Jaimee007/Modular_Drawers/docs/04_diseno_software.md

# Diseño de software

Versión 2.0 · Octubre 2026 · **Firmware del módulo, del controlador e integración en Home Assistant**

> **Alcance.** Qué software corre en cada sitio, cómo se organiza y en qué orden se construye y prueba. Implementa `01_especificacion_funcional.md` sobre el hardware de `02_diseno_hardware.md`.
>
> Entorno: **VS Code + PlatformIO**.

---

## 1. Las tres piezas de software

| Pieza | Dónde corre | Lenguaje / framework |
|---|---|---|
| **Firmware del módulo** | CH32V003 (uno por unidad de retícula) | C sobre `ch32v003fun` |
| **Firmware del controlador** | ESP32-C3 (módulo base) | C++ como componente externo de ESPHome |
| **Integración** | Home Assistant | YAML, plantillas y scripts |

### 1.1 Reparto de responsabilidades

El principio que lo gobierna todo viene del requisito **R1**:

> **Un cajón que se abre se ilumina aunque el controlador no responda.**

De ahí sale la línea divisoria:

| Lo decide **el módulo**, solo | Lo decide **el controlador** |
|---|---|
| Encender en blanco al abrir | Qué cajones están siendo buscados |
| El verde de "encontrado" y cancelar la búsqueda | El mapa de posiciones |
| Parpadear en ámbar si no tiene dirección | Detectar direcciones duplicadas y errores de montaje |
| Filtrar los rebotes del interruptor | Agrupar módulos emparejados en un cajón |
| Reiniciarse si se cuelga | Límites de brillo y de LED simultáneos |

**El módulo tiene prioridad.** Si el controlador pide azul y el cajón se abre, gana el blanco.

---

## 2. Estructura del repositorio

```
Modular_Drawers/
├── firmware/
│   ├── modulo/                  ← proyecto PlatformIO del CH32V003
│   │   ├── platformio.ini
│   │   ├── include/
│   │   │   ├── bus.h            ← protocolo y CRC, COMPARTIDO
│   │   │   └── funconfig.h
│   │   └── src/main.c
│   └── base_test/               ← proyecto del ESP32 (pruebas, fases 3-6)
│       ├── platformio.ini
│       └── src/main.cpp
├── esphome/
│   ├── components/cajonera/     ← componente externo (fase 7)
│   └── cajonera.yaml
└── homeassistant/
    ├── scripts.yaml
    └── dashboard.yaml
```

> **`bus.h` tiene que ser un único archivo compartido** por los dos proyectos. El formato de trama y el CRC duplicados en dos sitios es una fuente garantizada de fallos difíciles de diagnosticar.

### 2.1 Configuración de PlatformIO

**`firmware/modulo/platformio.ini`**

```ini
[env:modulo]
platform = https://github.com/Community-PIO-CH32V/platform-ch32v.git
board = genericCH32V003F4P6
framework = ch32v003fun
upload_protocol = minichlink
```

**`firmware/base_test/platformio.ini`**

```ini
[env:base]
platform = espressif32
board = esp32-c3-devkitm-1
framework = arduino
monitor_speed = 115200
build_flags =
  -DARDUINO_USB_MODE=1
  -DARDUINO_USB_CDC_ON_BOOT=1
```

Las dos `build_flags` hacen que el `Serial` del ESP32-C3 SuperMini salga por su USB-C.

**Por qué `ch32v003fun` y no Arduino:** ocupa muy poco (el micro tiene 16 kB de flash y 2 kB de RAM), da acceso directo al UART en modo half-duplex —que es lo que necesita el bus— y permite manejar los tres canales del LED por PWM.

---

## 3. Firmware del módulo

### 3.1 Al arrancar

1. Leer los **5 puentes de dirección** (una sola vez). Si la dirección es 0 → estado "sin configurar".
2. Leer los **2 puentes de emparejamiento** (JP7 izquierda, JP8 abajo).
3. Configurar los 4 SENSE como entradas con pull-up.
4. **Anunciarse:** poner los 4 SENSE a 0 durante 50 ms, para que los vecinos detecten el módulo nuevo.
5. Configurar la USART1 en half-duplex y los tres canales PWM del LED (PC6 = rojo, PC7 = verde, PD0 = azul).
6. Activar el watchdog.

### 3.2 Bus: lo que hay que acertar

| Asunto | Cómo |
|---|---|
| **Modo half-duplex** | Bit HDSEL de la USART1; el pin de DATA como salida de función alternativa **open-drain** |
| **El eco** | En half-duplex el receptor oye lo que transmite el propio micro. Hay que **descartar ese eco** o desactivar la recepción mientras se transmite |
| **Recepción** | Por interrupción, con búfer y máquina de estados que reconoce la trama |
| **Responder** | Solo si `DIR` coincide. Esperar ~100 µs antes de contestar, para que el controlador libere la línea |
| **Trama** | `[0xA5] [DIR] [CMD] [LEN] [DATOS...] [CRC8]` |

### 3.3 Máquina de estados del LED

Implementa la tabla de la especificación §4.1, con esta prioridad:

```
1. Sin dirección (ámbar parpadeante)      ← máxima
2. Cajón abierto (blanco, o verde 2 s si estaba buscado)
3. Lo que pida el controlador (búsqueda, error, identificar)
4. Reposo (apagado)                        ← mínima
```

**Detalle del LED RGB:** son **tres canales PWM** (R, G, B), uno por pin, a través de un MOSFET: pin a 1 = color encendido. No hay canal blanco: el "blanco" es R + G + B a la vez. Hay que comprobar que PC6, PC7 y PD0 admiten PWM por hardware (temporizadores TIM1/TIM2, con remapeo); si no, se hace por software. Los MOSFET dejan los colores apagados mientras el micro arranca, por la resistencia de 100 kΩ de cada puerta.

### 3.4 Final de carrera

- Entrada con pull-up. **Cerrado = pulsado = 0.**
- **Antirrebote por software, 25 ms:** el estado solo cambia si se mantiene estable ese tiempo.
- Al detectar apertura, **encender el LED en blanco inmediatamente**, sin consultar al bus.

### 3.5 SENSE

| Comando | Comportamiento |
|---|---|
| `SENSE_DRIVE n` | Poner a 0 el SENSE de la cara n |
| `SENSE_RELEASE` | Volver todos a entrada con pull-up |
| `SENSE_QUERY` | Si ve algún SENSE a 0 que él no está tirando, responde con su dirección y el número de cara. Si no ve ninguno, **no responde** |

**Interrupción en los SENSE:** al detectar un flanco de bajada que él no ha provocado, guarda el aviso "vecino nuevo en la cara k" para el siguiente `GET_STATE`.

### 3.6 Robustez

| Medida | Detalle |
|---|---|
| **Watchdog (IWDG)** | Si el firmware se cuelga, el micro se reinicia solo |
| **Tiempo sin órdenes** | Si pasan más de 30 s sin recibir nada del controlador, apaga la búsqueda pero **sigue encendiendo la luz al abrirse** |
| **Límite de brillo** | Por defecto en el firmware |

---

## 4. Firmware del controlador

### 4.1 Sondeo

| | |
|---|---|
| Cada ~100 ms | pregunta a todas las direcciones conocidas |
| Reintentos | 2 por sondeo; tras 3 fallos seguidos, marca el módulo como "desconectado" |
| Cada ~5 s | pregunta a direcciones desconocidas, para descubrir módulos nuevos |

Esto da una latencia de detección de apertura de ~0,1 s, holgadamente dentro del medio segundo que pide la especificación.

### 4.2 Descubrimiento de la topología

Implementa el algoritmo de `02_diseno_hardware.md` §9.2. Con un módulo por unidad de retícula, el cálculo de posición es directo:

| Cara | Posición del vecino |
|---|---|
| arriba | `(x, y+1)` |
| abajo | `(x, y−1)` |
| derecha | `(x+1, y)` |
| izquierda | `(x−1, y)` |

**Validaciones que debe hacer:**

| Comprobación | Si falla |
|---|---|
| Dos módulos en la misma celda | error de montaje |
| Conexión recíproca (si A ve a B por la derecha, B debe ver a A por la izquierda) | error de montaje |
| Un módulo declara pareja donde no tiene vecino | error de montaje |
| Un módulo sin camino hasta la base | "sin posición", pero sigue funcionando |

### 4.3 Agrupación de cajones

A partir de los puentes JP7/JP8:

1. Cada módulo que declara "pareja a la izquierda" se une al de `(x−1, y)`.
2. Cada módulo que declara "pareja abajo" se une al de `(x, y−1)`.
3. El **módulo principal** de un grupo es el que no declara nada. Da nombre a la entidad.
4. Un grupo expone **una sola entidad de cajón** en Home Assistant.
5. Una orden de iluminación al grupo se envía a **todos** sus módulos.

### 4.4 Límites

| Límite | Valor |
|---|---|
| LED encendidos a la vez | 10 |
| Brillo máximo | limitado |
| Duración de una búsqueda | 30 s |

---

### 4.5 Pines de la SuperMini

Misma asignación que `02_diseno_hardware.md` §10. El firmware la usa tal cual:

| GPIO | Función |
|---|---|
| GPIO21 (TX) | Bus DATA, a través del Schottky |
| GPIO20 (RX) | Bus DATA |
| GPIO0 / GPIO1 / GPIO3 / GPIO10 | SENSE L / R / U / D |
| GPIO8 | LED de estado |

## 5. Integración en Home Assistant

### 5.1 Entidades que publica el componente

Por cada **cajón** (no por módulo):

| Entidad | Uso |
|---|---|
| `light.cajon_NN` | RGB con efectos de parpadeo |
| `binary_sensor.cajon_NN_abierto` | Estado del cajón |
| `text.cajon_NN_contenido` | Descripción; **persistida en el ESP32** (requisito R6) |
| `sensor.cajon_NN_x`, `_y`, `_tamano` | Para dibujar la cajonera |

Y a nivel de sistema: un botón **"Redescubrir cajonera"** y entidades de aviso para cajones nuevos, direcciones duplicadas y errores de montaje.

### 5.2 Búsqueda

Script `buscar_componente`:

1. Recibe un texto ("10k").
2. Lo busca en el `text` de contenido de cada cajón.
3. Hace parpadear en azul los que coinciden.
4. Los apaga al abrirse uno, o a los 30 s.

**Assist (voz):** un intent personalizado del tipo *"¿dónde están las {cosa}?"* que llama al script.

**Panel:** una tarjeta con la cuadrícula dibujada a partir de las posiciones X/Y, el color de cada cajón y su contenido. Al tocar un cajón, se identifica parpadeando.

### 5.3 Plan B

Si el componente externo de ESPHome se complica, se mantiene el firmware Arduino de `base_test` y se publican las entidades por **MQTT con descubrimiento automático**. Funciona igual en Home Assistant.

---

## 6. Plan de construcción y pruebas

Cada fase termina con una **prueba de aceptación**. No pasar a la siguiente hasta que la anterior funcione: así, cuando algo falle, el problema está en lo último que se añadió.

| Fase | Objetivo | Hardware | Duración |
|---|---|---|---|
| 0 | Entorno y repositorio | PC, WCH-LinkE | 1–2 h |
| 1 | Primer programa: parpadeo y `printf` | 1 micro | 1 h |
| 2 | Periféricos, uno a uno | + LED, interruptor, puentes | 3–4 h |
| 3 | Bus DATA: el controlador habla con un módulo | + ESP32, diodo Schottky, resistencias | 4–6 h |
| 4 | Dos módulos en el mismo bus | 2.º micro | 1–2 h |
| 5 | SENSE: descubrimiento de posición | Cables entre placas | 3–4 h |
| 6 | Emparejamiento y lógica completa | — | 3–4 h |
| 7 | Integración con Home Assistant | HA funcionando | 4–6 h |
| 8 | Búsqueda, panel y voz | — | 2–3 h |
| 9 | Prueba final con cajones impresos | Armazones v1 | 2 h |

### Fase 0 · Entorno

1. **VS Code** y la extensión **PlatformIO IDE**.
2. La plataforma CH32V: `pio pkg install -g -p https://github.com/Community-PIO-CH32V/platform-ch32v.git`
3. **WCH-LinkUtility**, para dos cosas:
   - **Actualizar el firmware del WCH-LinkE.** Con firmware antiguo, la grabación falla con "Programming Failed".
   - **Ponerlo en modo RISC-V.** El WCH-LinkE tiene modo ARM y modo RISC-V; **en modo ARM no reconoce el CH32V003**. Se cambia desde la utilidad o con el botón "ModeS".

✅ **Aceptación:** los dos proyectos compilan.

### Fase 1 · Primer programa

**Conexión del programador:**

| WCH-LinkE | Módulo |
|---|---|
| 3V3 | 3V3 — **solo si no hay 5 V en el bus** |
| GND | GND |
| SWDIO | SWIO |

> ⚠️ Si el módulo ya recibe corriente del bus, conecta **solo GND y SWIO**. Dos fuentes peleando por el raíl de 3,3 V.

`printf` sale por el mismo hilo SWIO que se usa para programar, lo cual es muy útil porque el UART del micro estará ocupado con el bus. Se activa en `funconfig.h` y se lee con `minichlink -T`.

✅ **Aceptación:** el LED parpadea, se ve el contador en el terminal, y se puede grabar 5 veces seguidas sin errores.

### Fase 2 · Periféricos

| Bloque | Prueba | Aceptación |
|---|---|---|
| **LED RGB** | Ciclo rojo → verde → azul → blanco (R+G+B) → apagado | Colores limpios, sin parpadeos raros, y el blanco reconocible como blanco |
| **Final de carrera** | Imprimir "ABIERTO"/"CERRADO" en cada cambio | 50 aperturas y cierres generan **exactamente 100 eventos**, sin duplicados por rebotes |
| **Puentes** | Imprimir dirección y emparejamiento al arrancar | Las direcciones 1, 2, 21 y 31 se leen bien; con dirección 0 el LED parpadea en ámbar |
| **SENSE** | Imprimir el estado de los 4 pines cada 200 ms | Cada pin cambia a 0 solo al llevarlo a GND, sin afectar a los otros |

### Fase 3 · Bus DATA

**Montaje:**

| Conexión | Detalle |
|---|---|
| GND común | ESP32, micro y programador |
| Pull-up del bus | 4,7 kΩ entre DATA y 3V3, **solo en la base** |
| ESP32 RX | Directo a DATA |
| ESP32 TX | A DATA a través de un diodo Schottky (cátodo hacia el TX) |
| Micro DATA | A través de 1 kΩ |

**Menú de pruebas por el monitor serie:**

```
ping 1            → PING al módulo 1
led 1 0 0 255     → módulo 1 en azul (R G B)
state 1           → estado (abierto/cerrado)
stress 1 1000     → 1000 PING seguidos y recuento de errores
```

**Depuración con el analizador lógico** (canales según los puntos de test de la placa): DATA, LED, y dos SENSE. En PulseView, decodificador UART a 115200 8N1 sobre el canal de DATA.

✅ **Aceptación:** `ping 1` responde siempre, `led` cambia el color al momento, y `stress 1 1000` da **0 errores**.

### Fase 4 · Dos módulos

1. Segundo módulo con **dirección 2**, su DATA a la misma línea con su propia resistencia de 1 kΩ.
2. `ping 1` y `ping 2` responden por separado; `led 1 …` solo afecta al módulo 1.
3. **Prueba de error:** poner los dos en la dirección 1. El controlador debe recibir respuesta corrupta (CRC incorrecto) y avisar de "dirección duplicada".

✅ **Aceptación:** los dos responden de forma independiente, `stress` a los dos da 0 errores, y la duplicación se detecta.

### Fase 5 · SENSE y posición

**Montaje:** une los SENSE entre módulos, con 1 kΩ en cada lado.

**Pruebas:**

1. `map` muestra la posición correcta.
2. Cambiar el orden físico de los módulos → `map` lo refleja.
3. Desconectar y reconectar la alimentación de un módulo → el controlador avisa de módulo nuevo y lo recoloca **sin reiniciar nada**.
4. Quitar el cable SENSE entre dos módulos → uno aparece "sin posición" pero sigue respondiendo al bus.

✅ **Aceptación:** las cuatro pruebas dan el resultado esperado.

### Fase 6 · Emparejamiento y lógica completa

1. **Agrupación:** cierra JP7 en un módulo y comprueba que el controlador lo agrupa con su vecino de la izquierda y expone **una sola entidad**.
2. **Validación:** cierra JP7 en un módulo que **no** tiene vecino a la izquierda → debe avisar de error de montaje.
3. **Cable en Y:** un solo interruptor a los J7 de dos módulos emparejados → al abrir, **los dos** se iluminan en blanco.
4. **Prioridad:** con un cajón en azul por búsqueda, abrirlo debe ponerlo en verde y luego en blanco.
5. **Autonomía (requisito R1):** desconecta el controlador y abre un cajón → **debe iluminarse igual**.

✅ **Aceptación:** las cinco pruebas pasan. Especialmente la 5.

### Fase 7 · Home Assistant

1. Pasar la lógica de `base_test` a un componente externo de ESPHome en C++.
2. UART de ESPHome en los mismos pines, sin cambios de hardware.
3. Grabar la primera vez por USB; las siguientes por OTA.

✅ **Aceptación:** los cajones aparecen como dispositivos; encender una luz tarda menos de 0,5 s; abrir un cajón actualiza su sensor en menos de 0,5 s; tras reiniciar el ESP32 todo vuelve solo.

### Fase 8 · Búsqueda, panel y voz

✅ **Aceptación:** escribir o decir "resistencias de 10k" ilumina el cajón correcto; al abrirlo se pone verde y luego blanco.

### Fase 9 · Prueba final

1. Pasar los módulos a su forma definitiva dentro de los armazones impresos.
2. Repetir las pruebas clave de las fases 3, 5 y 8.
3. **Prueba mecánica:** 100 aperturas y cierres de cada cajón sin un fallo de detección.
4. **Prueba de resistencia:** 24 h con el controlador encendiendo un cajón al azar cada minuto.

✅ **Aceptación final:** los criterios **A1–A11** de la especificación funcional, con hardware real.

---

## 7. Problemas típicos

| Síntoma | Causa probable | Solución |
|---|---|---|
| "Programming Failed" al grabar | Firmware del WCH-LinkE antiguo, o en modo ARM | Actualizarlo y ponerlo en modo RISC-V |
| No detecta el chip | SWIO o GND mal, o placa sin alimentación | Comprobar las 3 conexiones |
| El controlador recibe basura | Falta GND común, o no se descarta el eco | Unir masas; descartar los bytes propios |
| El módulo no responde nunca | El pin de DATA no está en open-drain, o falta HDSEL | Revisar la USART; mirar la línea con el analizador |
| Colores mal o el LED no hace caso | LED de cátodo común en vez de ánodo común, o MOSFET/resistencia de puerta mal puestos | Comprobar la polaridad del LED y el circuito de `02_diseno_hardware.md` §5.1 |
| Eventos dobles al abrir | Rebotes del interruptor | Subir el filtro a 30–40 ms |
| SENSE siempre a 0 | Pull-up sin activar, o pin como salida | Revisar la configuración al arrancar y tras `SENSE_RELEASE` |
| El mapa sale incoherente | **Latiguillo en la cara equivocada** | Comprobar la serigrafía `L R U D` de cada conector |
| Un cajón emparejado se ilumina solo a medias | El cable en Y del interruptor, o JP7/JP8 mal puestos | Revisar los puentes y la continuidad del cable en Y |
