Jaimee007/Modular_Drawers/Hardware/modulo_cajon/modulo_cajon.kicad_pcb

## KiCad design Hardware/modulo_cajon/modulo_cajon.kicad_pcb (2026-11-12)

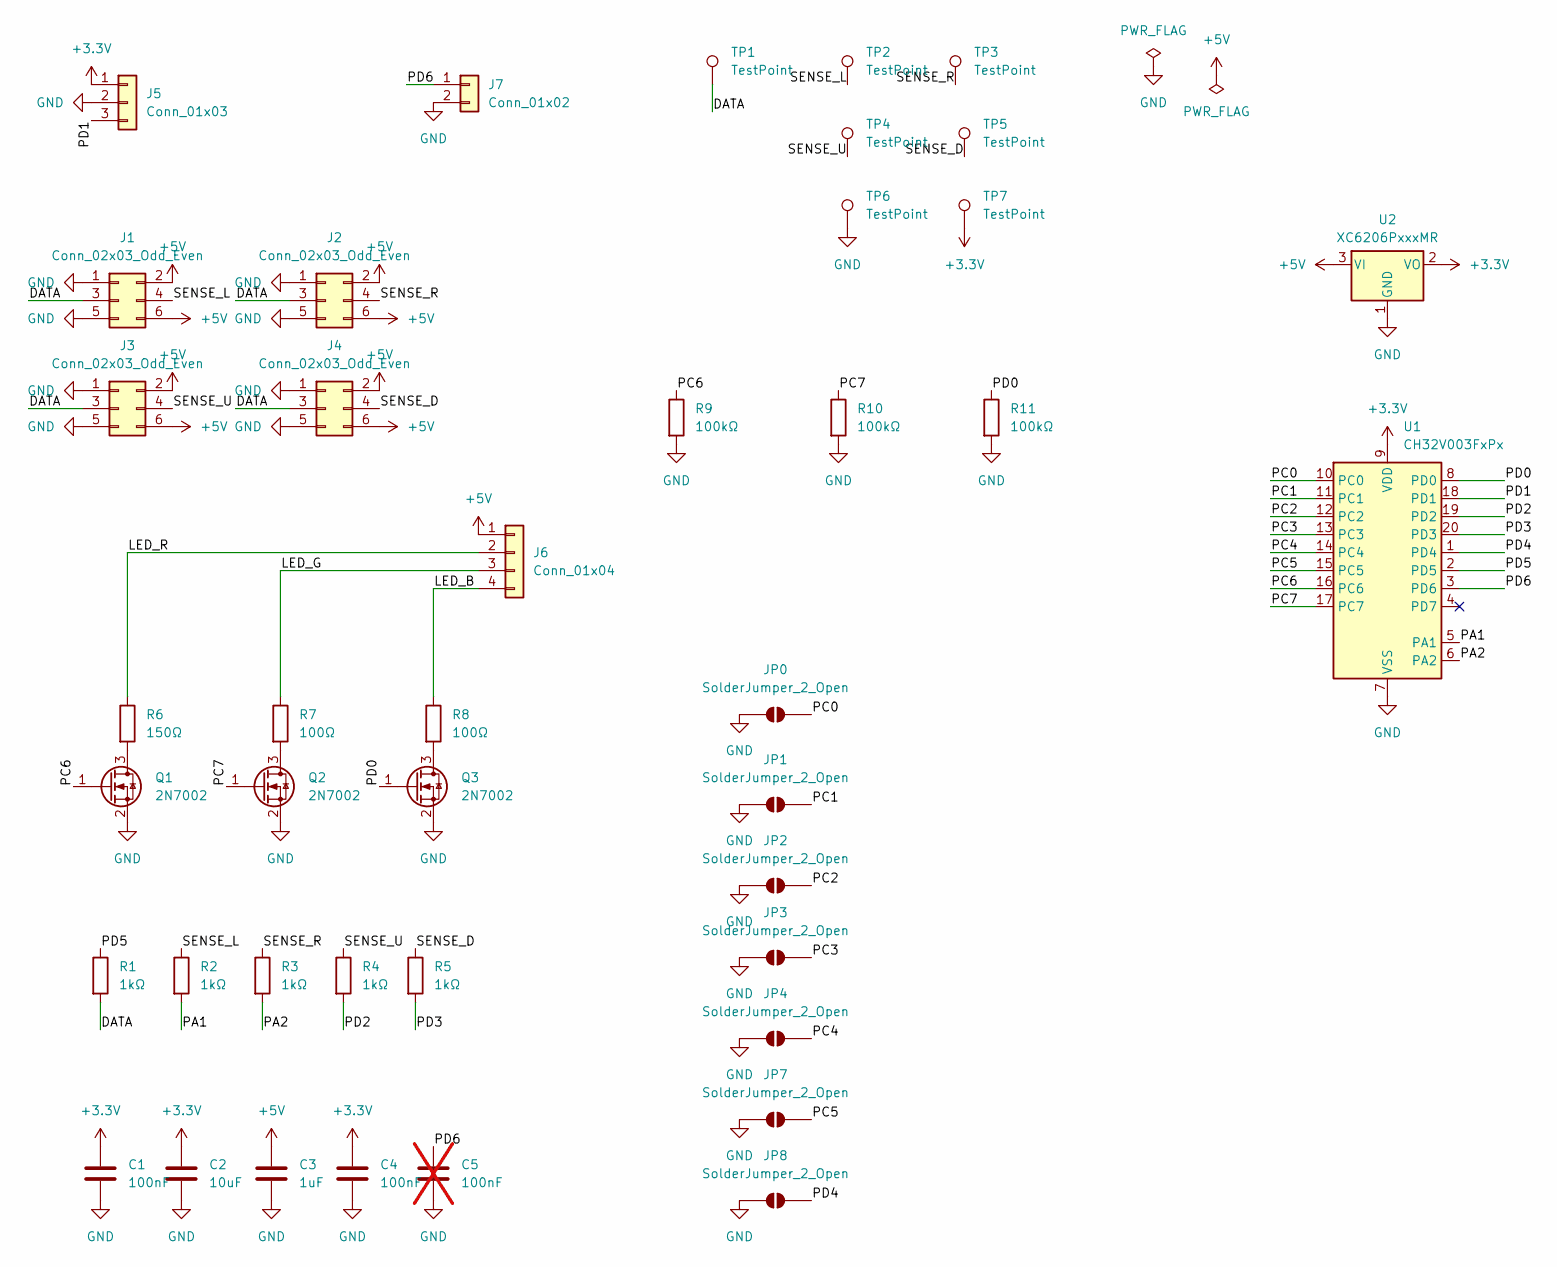
[picture p1: schematic modulo_cajon.kicad_sch]

Parts:
C1, C4: 100nF; C_0603_1608Metric
C2: 10uF; C_0805_2012Metric
C3: 1uF; C_0603_1608Metric
C5: 100nF; C_0603_1608Metric; not fitted
J1, J2, J3, J4: Conn_02x03_Odd_Even; IDC-Header_2x03_P2.54mm_Vertical
J5: Conn_01x03; PinHeader_1x03_P2.54mm_Vertical
J6: Conn_01x04; PinHeader_1x04_P2.54mm_Vertical
J7: Conn_01x02; PinHeader_1x02_P2.54mm_Vertical
JP0, JP1, JP2, JP3, JP4, JP7, JP8: SolderJumper_2_Open; SolderJumper-2_P1.3mm_Open_Pad1.0x1.5mm
Q1, Q2, Q3: 2N7002; SOT-23
R1, R2, R3, R4, R5: 1kΩ; R_0603_1608Metric
R6: 150Ω; R_0603_1608Metric
R7, R8: 100Ω; R_0603_1608Metric
R9, R10, R11: 100kΩ; R_0603_1608Metric
TP1, TP2, TP3, TP4, TP5, TP6, TP7: TestPoint; TestPoint_Pad_D1.5mm
U1: CH32V003FxPx; TSSOP-20_4.4x6.5mm_P0.65mm
U2: XC6206PxxxMR; SOT-23-3

Connections:
+3.3V: C1.1, C2.1, C4.1, J5.1, TP7.1 (1_1), U1.9 (VDD), U2.2 (VO)
+5V: C3.1, J1.2, J1.6, J2.2, J2.6, J3.2, J3.6, J4.2, J4.6, J6.1, U2.3 (VI)
/DATA: J1.3, J2.3, J3.3, J4.3, R1.2, TP1.1 (1_1)
/LED_B: J6.4, R8.1
/LED_G: J6.3, R7.1
/LED_R: J6.2, R6.1
/PA1: R2.2, U1.5 (PA1)
/PA2: R3.2, U1.6 (PA2)
/PC0: JP0.2 (B), U1.10 (PC0)
/PC1: JP1.2 (B), U1.11 (PC1)
/PC2: JP2.2 (B), U1.12 (PC2)
/PC3: JP3.2 (B), U1.13 (PC3)
/PC4: JP4.2 (B), U1.14 (PC4)
/PC5: JP7.2 (B), U1.15 (PC5)
/PC6: Q1.1 (G), R9.1, U1.16 (PC6)
/PC7: Q2.1 (G), R10.1, U1.17 (PC7)
/PD0: Q3.1 (G), R11.1, U1.8 (PD0)
/PD1: J5.3, U1.18 (PD1)
/PD2: R4.2, U1.19 (PD2)
/PD3: R5.2, U1.20 (PD3)
/PD4: JP8.2 (B), U1.1 (PD4)
/PD5: R1.1, U1.2 (PD5)
/PD6: C5.1, J7.1, U1.3 (PD6)
/SENSE_D: J4.4, R5.1, TP5.1 (1_1)
/SENSE_L: J1.4, R2.1, TP2.1 (1_1)
/SENSE_R: J2.4, R3.1, TP3.1 (1_1)
/SENSE_U: J3.4, R4.1, TP4.1 (1_1)
GND: C1.2, C2.2, C3.2, C4.2, C5.2, J1.1, J1.5, J2.1, J2.5, J3.1, J3.5, J4.1, J4.5, J5.2, J7.2, JP0.1 (A), JP1.1 (A), JP2.1 (A), JP3.1 (A), JP4.1 (A), JP7.1 (A), JP8.1 (A), Q1.2 (S), Q2.2 (S), Q3.2 (S), R9.2, R10.2, R11.2, TP6.1 (1_1), U1.7 (VSS), U2.1 (GND)
unnamed: Q1.3 (D), R6.2
unnamed: Q2.3 (D), R7.2
unnamed: Q3.3 (D), R8.2

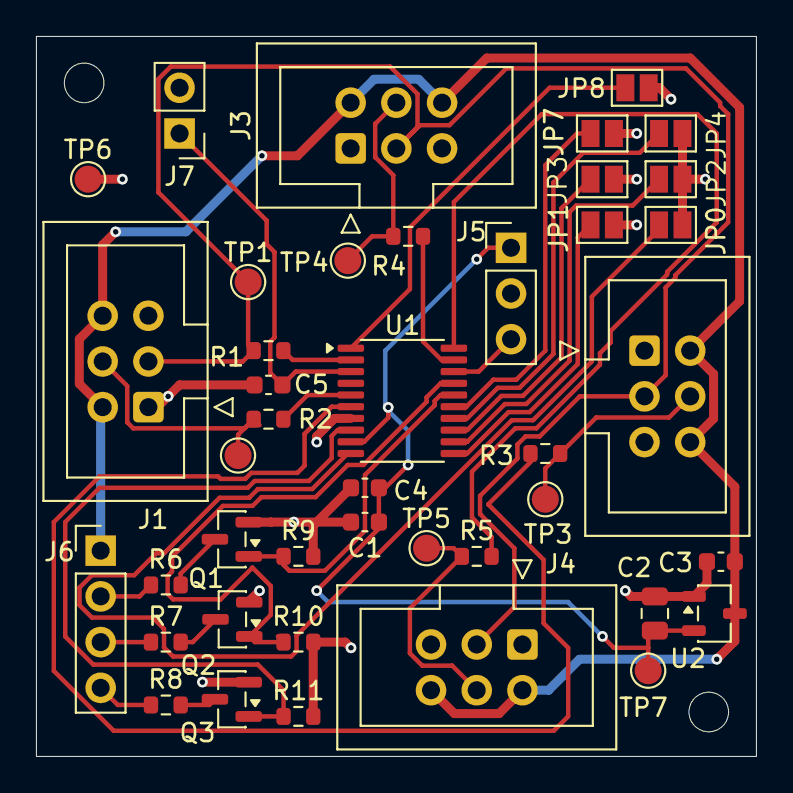
[picture p2: board modulo_cajon.kicad_pcb from above]

Board: 2 copper layers, 40.0 x 40.0 mm, 42 parts (0 on the bottom side), 31 nets.
