Jaimee007/Modular_Drawers/Hardware/devboard_ch32v003/devboard_ch32v003.kicad_pcb

## KiCad design Hardware/devboard_ch32v003/devboard_ch32v003.kicad_pcb (2026-10-26)

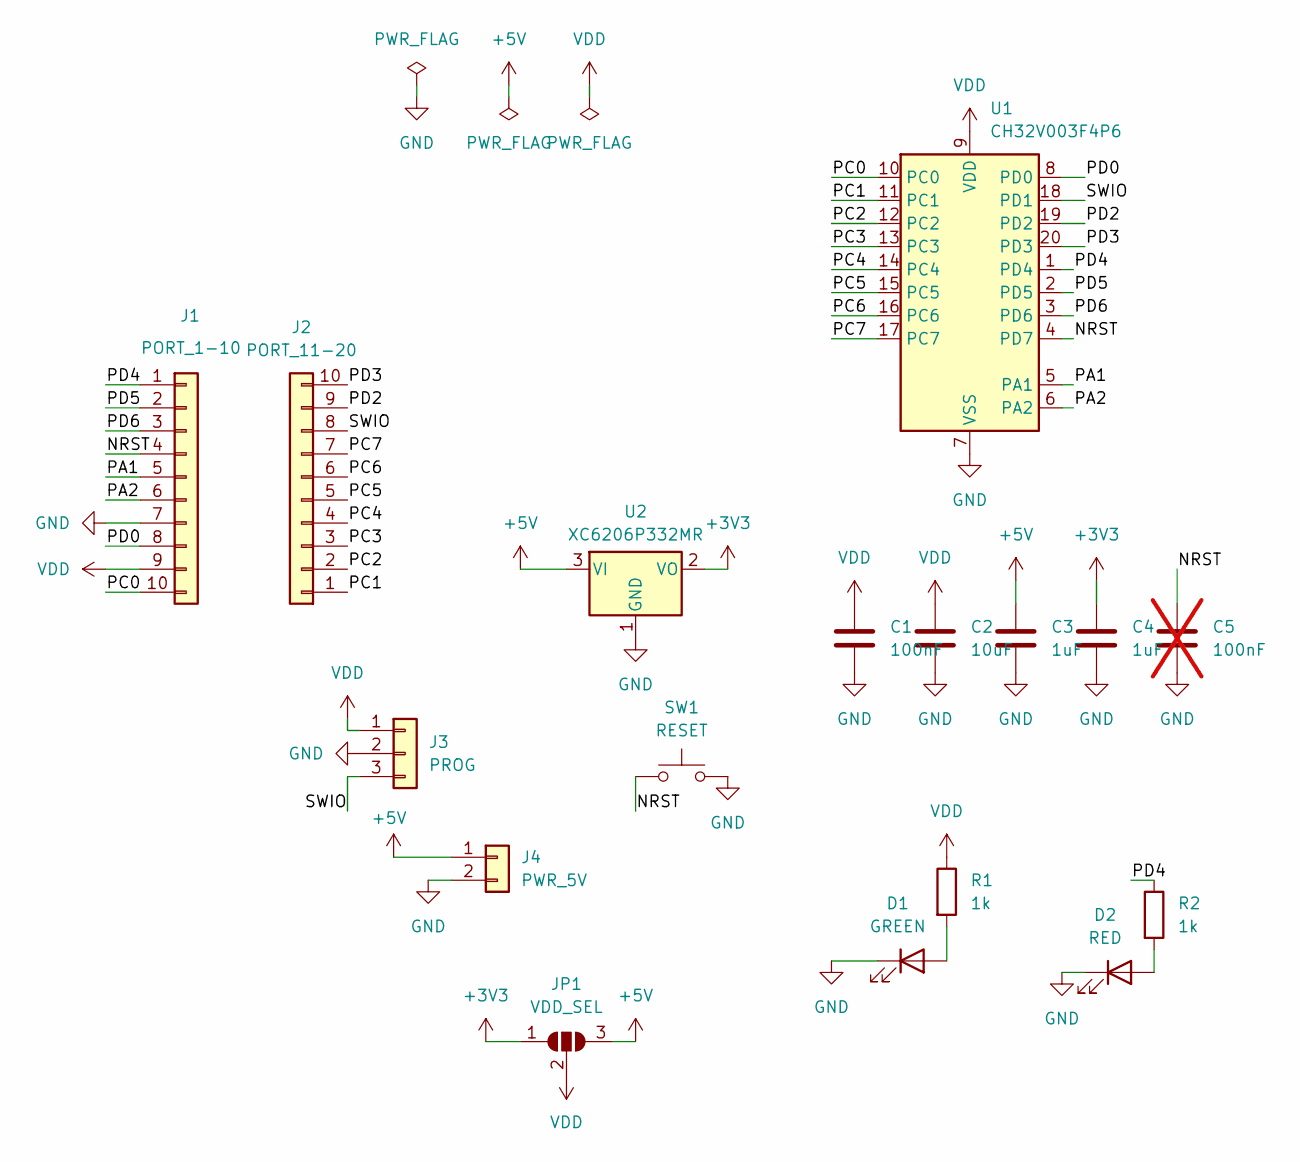
[picture p3: schematic devboard_ch32v003.kicad_sch]

Parts:
C1: 100nF; C_0603_1608Metric
C2: 10uF; C_0805_2012Metric
C3, C4: 1uF; C_0603_1608Metric
C5: 100nF; C_0603_1608Metric; not fitted
D1: GREEN; LED_0603_1608Metric
D2: RED; LED_0603_1608Metric
J1: PORT_1-10; PinHeader_1x10_P2.54mm_Vertical
J2: PORT_11-20; PinHeader_1x10_P2.54mm_Vertical
J3: PROG; PinHeader_1x03_P2.54mm_Vertical
J4: PWR_5V; PinHeader_1x02_P2.54mm_Vertical
JP1: VDD_SEL; SolderJumper-3_P1.3mm_Open_Pad1.0x1.5mm
R1, R2: 1k; R_0603_1608Metric
SW1: RESET; SW_PUSH_6mm
U1: CH32V003F4P6; TSSOP-20_4.4x6.5mm_P0.65mm
U2: XC6206P332MR; SOT-23-3

Connections:
+3V3: C4.1, JP1.1 (A), U2.2 (VO)
+5V: C3.1, J4.1, JP1.3 (B), U2.3 (VI)
/NRST: C5.1, J1.4, SW1.1, U1.4 (PD7)
/PA1: J1.5, U1.5 (PA1)
/PA2: J1.6, U1.6 (PA2)
/PC0: J1.10, U1.10 (PC0)
/PC1: J2.1, U1.11 (PC1)
/PC2: J2.2, U1.12 (PC2)
/PC3: J2.3, U1.13 (PC3)
/PC4: J2.4, U1.14 (PC4)
/PC5: J2.5, U1.15 (PC5)
/PC6: J2.6, U1.16 (PC6)
/PC7: J2.7, U1.17 (PC7)
/PD0: J1.8, U1.8 (PD0)
/PD2: J2.9, U1.19 (PD2)
/PD3: J2.10, U1.20 (PD3)
/PD4: J1.1, R2.1, U1.1 (PD4)
/PD5: J1.2, U1.2 (PD5)
/PD6: J1.3, U1.3 (PD6)
/SWIO: J2.8, J3.3, U1.18 (PD1)
GND: C1.2, C2.2, C3.2, C4.2, C5.2, D1.1 (K), D2.1 (K), J1.7, J3.2, J4.2, SW1.2, U1.7 (VSS), U2.1 (GND)
unnamed: D1.2 (A), R1.2
unnamed: D2.2 (A), R2.2
VDD: C1.1, C2.1, J1.9, J3.1, JP1.2 (C), R1.1, U1.9 (VDD)

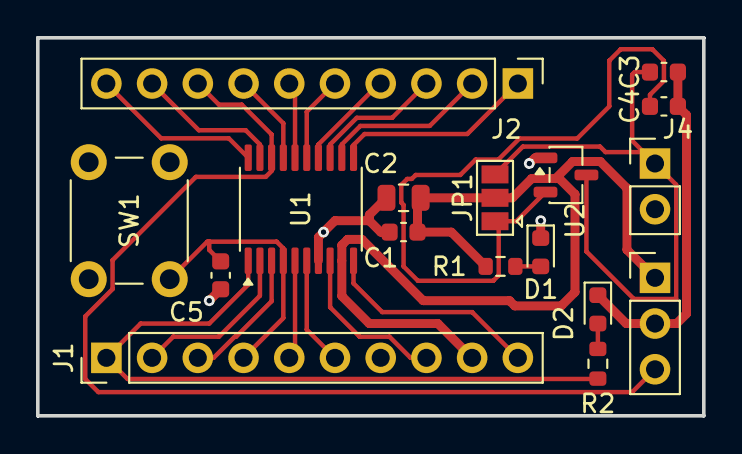
[picture p4: board devboard_ch32v003.kicad_pcb from above]

Board: 2 copper layers, 37.0 x 21.0 mm, 17 parts (0 on the bottom side), 24 nets.
