Jaimee007/Modular_Drawers/(commit log)

2026-10-24 Añadir documentación inicial de la cajonera modular
    - Plan de diseño v1.1 (conexión por cable plano IDC)
    - BOM para prototipo de 5 cajones con referencias de JLCPCB
    - Esquemático de referencia (base ESP32-C3 + 2 cajones CH32V003) y su generador
    - README con resumen del proyecto
2026-10-24 Añadir plan de firmware y pruebas (PlatformIO → Home Assistant)
2026-10-26 KiCad: esquemático de la devboard
    [devboard_ch32v003.kicad_pcb, devboard_ch32v003.kicad_sch]
2026-10-26 First iteration done
    [devboard_ch32v003.kicad_pcb, devboard_ch32v003.kicad_sch]
2026-11-11 Actualizar diseño PCB
2026-11-11 Add drawer pcb schematics
    [modulo_cajon.kicad_pcb, modulo_cajon.kicad_sch]
2026-11-12 Add pcb and simulation files
    [modulo_cajon.kicad_pcb, modulo_cajon.kicad_sch, sim_ldo.kicad_pcb, sim_ldo.kicad_sch, sim_led.kicad_pcb, sim_led.kicad_sch]
2026-11-12 Document LDO/LED simulation results and untrack KiCad junk
    - Confirm 2N7002 (LCSC C8545, JSCJ) as Basic part in the PCB and BOM docs.
    - Document XC6206 capacitors: 1 uF input, 10 uF + 2x100 nF output, matching
    the Torex typical application circuit.
    - Ignore .history/ and *.lck everywhere and stop tracking the nested
    .history repositories and lock files.
2026-11-12 Add confirmed LCSC codes and SENSE bench test with two dev boards
    - Fill LCSC codes for the passives (R 1k, C 100nF/1uF/10uF) in the PCB and
    BOM docs; all confirmed as Basic parts in the JLCPCB BOM matcher.
    - Add section 5.0 to the firmware plan: electrical-level SENSE tests that
    can be run with two CH32V003 dev boards before DATA and the ESP32 exist.
2026-11-13 Add breadboard wiring guide and align firmware plan with v2 hardware
    - Add docs/06_montaje_protoboard.md: connection tables for the SuperMini
    base plus two CH32V003 dev boards (power, DATA, SENSE, address), with
    pre-power continuity checks and a per-phase test map.
    - Align plan_firmware.md with the current design: DATA on GPIO20/21, plain
    RGB LED driven by three 2N7002 on PC6/PC7/PD0, five address bits on
    PC0-PC4 and pairing jumpers on PC5/PD4. Drop the addressable-LED, RGBW
    and 6-bit-address leftovers.
    - Fix the led test command in 04_diseno_software.md (R G B only).
